ntosis/ARMGarageDoor/PCB/design/Untitled 1.ods

pin name | pin no | connection | info
cph | 22 | 47nF capacitor | default
cpl | 23 | 47nF capacitor | default
dvdd | 1 | 1 uF capacitor | default
EN/IN1 | 7 | PB9 PWM
DISABLE | 9 | PB15 OUT
IPROPI1 | 10 | PA1 ADC | R(SENSE)= k × 3 V / I, k=1100, I max current = 7.8 A R=412ohm, 21mW
IPROPI2 | 12 | PA2 ADC | R(SENSE)= k × 3 V / I, k=1100, I max current = 7.8 A R=412ohm, 21mW
nITRIP | 5 | nc | enables current protection at 6.5 A and off time is 40uS
nOL | 6 | connect to dvdd | disables openload detection
MODE | 3 | connect to dvdd | pwm mode
PH/IN2 | 8 | PB8 PWM
sr | 4 |  | slew rate 18,3 v/us. 68 k Ω ± 5% to GND
src | 16 | to gnd
src | 17 | to gnd
VCP | 21 |  | Chargepumpoutput.Connecta 16-V,1-μF ceramiccapacitorfromthis pin tothe VM supply.
VM | 13 |  | Powersupply This pin is the motor supply voltage.
VM | 20 |  | Powersupply This pin is the motor supply voltage.
nFAULT | 2 | PB1 IN | Faultindicationpin. This pin is pulled logic low with a fault condition.This open-drain output requiresan external pullup resistor. 10Kohm
nSLEEP | 11 | PB11 OUT | Sleep input.To enter a low-power sleepmode,set this pin logic low.
