ntosis/ARMGarageDoor/PCB/motordriver.brd

## EAGLE design PCB/motordriver.brd (2019-07-03)

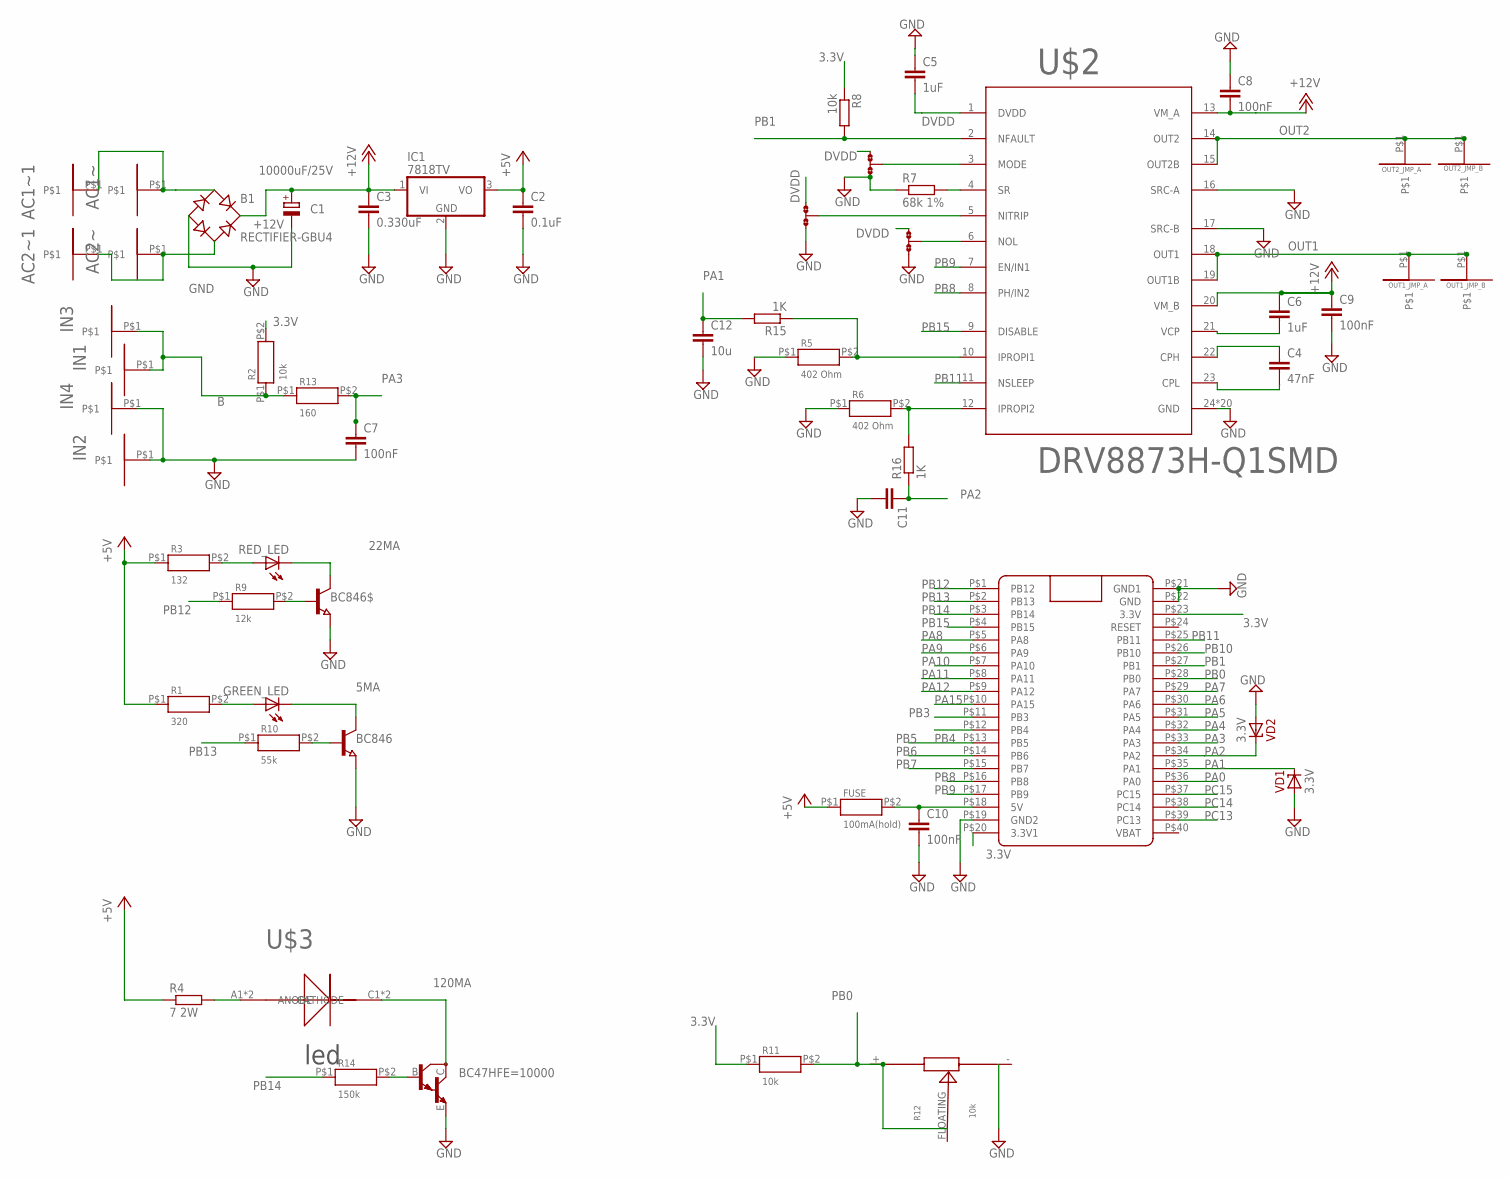
[picture p3: schematic motordriver.sch]

Parts:
AC1~, AC1~1, AC2~, AC2~1: SMDPAD; 1.5X7MMPAD
B1: RECTIFIER-GBU4; GBU4
BC47HFE=10000: MMBTA14LT1; SOT23-BEC
BC846, BC846$: NPN-TRANSISTOR_SOT23; SOT23
C1: 10000uF/25V; E7,5-18
C2: 0.1uF; C1206
C3: 0.330uF; C1206
C4: 47nF; C1206K
C5, C6: 1uF; C1206K
C7: 100nF; C1206
C8, C9: 100nF; C0805
C10: 100nF; C0805K
C11: C-EUC0805K; C0805K
C12: 10u; C0805K
FUSE: 100mA(hold); 0805
GREEN_LED: LEDCHIPLED_0805; CHIPLED_0805
IC1: 7818TV; TO220V
IN1, IN2, IN3, IN4: SMDPAD; 1.5X7MMPAD
JMP1, JMP2, JMP3: 0R-JUMPA; A0R-JMP
OUT1_JMP_A, OUT1_JMP_B, OUT2_JMP_A, OUT2_JMP_B: SMDPAD; 1.5X7MMPAD
R1: 320; 0805
R2, R11: 10k; 0805
R3: 132; 0805
R4: 7 2W; R1210
R5, R6: 402 Ohm; 0805
R7: 68k 1%; R0805
R8: 10k; R0805
R9: 12k; 0805
R10: 55k; 0805
R12: 10k; 3X1MM
R13: 160; 0805
R14: 150k; 0805
R15, R16: 1K; R0805
RED_LED: LEDCHIPLED_0805; CHIPLED_0805
U$1: BLUE_PILL
U$2: DRV8873H-Q1SMD; HTSSOP24
U$3: POWER_LED; OSRAMLED
VD1, VD2: 3.3V; DO35-7

Connections:
3.3V: R2.P$2, R8.1, R11.P$1, U$1.P$20 (3.3V1), U$1.P$23 (3.3V)
5MA: BC846.3 (C), GREEN_LED.C
22MA: BC846$.3 (C), RED_LED.C
120MA: BC47HFE=10000.C, U$3.C1 (CATHODE), U$3.C2 (CATHODE)
+5V: C2.1, FUSE.P$1, IC1.3 (VO), R1.P$1, R3.P$1, R4.1
+12V: B1.+, C1.+, C3.1, C6.1, C8.2, C9.1, IC1.1 (VI), U$2.13 (VM_A), U$2.20 (VM_B)
B: IN1.P$1, IN3.P$1, R2.P$1, R13.P$1
DVDD: C5.2, JMP1.1, JMP2.1, JMP3.1, U$2.1 (DVDD)
GND: B1.-, BC47HFE=10000.E, BC846.2 (E), BC846$.2 (E), C1.-, C2.2, C3.2, C5.1, C7.2, C8.1, C9.2, C10.2, C11.2, C12.2, IC1.2 (GND), IN2.P$1, IN4.P$1, JMP1.3, JMP2.3, JMP3.3, R5.P$1, R6.P$1, R7.1, R12.-, U$1.P$19 (GND2), U$1.P$21 (GND1), U$1.P$22 (GND), U$2.16 (SRC-A), U$2.17 (SRC-B), U$2.24 (GND), U$2.GND_ (GND), U$2.P$1 (GND), U$2.P$2 (GND), U$2.P$3 (GND), U$2.P$4 (GND), U$2.P$5 (GND), U$2.P$6 (GND), U$2.P$7 (GND), U$2.P$8 (GND), U$2.P$9 (GND), U$2.P$10 (GND), U$2.P$11 (GND), U$2.P$12 (GND), U$2.P$13 (GND), U$2.P$14 (GND), U$2.P$15 (GND), U$2.P$16 (GND), U$2.P$18 (GND), U$2.P$19 (GND), VD1.A, VD2.A
unnamed: AC1~.P$1, AC1~1.P$1, B1.AC1
unnamed: AC2~.P$1, AC2~1.P$1, B1.AC2
unnamed: C4.1, U$2.22 (CPH)
unnamed: C4.2, U$2.23 (CPL)
unnamed: JMP2.2, U$2.6 (NOL)
unnamed: JMP1.2, U$2.5 (NITRIP)
unnamed: JMP3.2, U$2.3 (MODE)
unnamed: R7.2, U$2.4 (SR)
unnamed: C6.2, U$2.21 (VCP)
unnamed: R3.P$2, RED_LED.A
unnamed: GREEN_LED.A, R1.P$2
unnamed: BC846$.1 (B), R9.P$2
unnamed: BC846.1 (B), R10.P$2
unnamed: R4.2, U$3.A1 (ANODE), U$3.A2 (ANODE)
unnamed: BC47HFE=10000.B, R14.P$2
unnamed: C10.1, FUSE.P$2, U$1.P$18 (5V)
unnamed: R5.P$2, R15.1, U$2.10 (IPROPI1)
unnamed: R6.P$2, R16.2, U$2.12 (IPROPI2)
OUT1: OUT1_JMP_A.P$1, OUT1_JMP_B.P$1, U$2.18 (OUT1), U$2.19 (OUT1B)
OUT2: OUT2_JMP_A.P$1, OUT2_JMP_B.P$1, U$2.14 (OUT2), U$2.15 (OUT2B)
PA0: U$1.P$36 (PA0)
PA1: C12.1, R15.2, U$1.P$35 (PA1), VD1.C
PA2: C11.1, R16.1, U$1.P$34 (PA2), VD2.C
PA3: C7.1, R13.P$2, U$1.P$33 (PA3)
PA4: U$1.P$32 (PA4)
PA5: U$1.P$31 (PA5)
PA6: U$1.P$30 (PA6)
PA7: U$1.P$29 (PA7)
PA8: U$1.P$5 (PA8)
PA9: U$1.P$6 (PA9)
PA10: U$1.P$7 (PA10)
PA11: U$1.P$8 (PA11)
PA12: U$1.P$9 (PA12)
PA15: U$1.P$10 (PA15)
PB0: R11.P$2, R12.+, R12.FLOATING, U$1.P$28 (PB0)
PB1: R8.2, U$1.P$27 (PB1), U$2.2 (NFAULT)
PB3: U$1.P$11 (PB3)
PB4: U$1.P$12 (PB4)
PB5: U$1.P$13 (PB5)
PB6: U$1.P$14 (PB6)
PB7: U$1.P$15 (PB7)
PB8: U$1.P$16 (PB8), U$2.8 (PH/IN2)
PB9: U$1.P$17 (PB9), U$2.7 (EN/IN1)
PB10: U$1.P$26 (PB10)
PB11: U$1.P$25 (PB11), U$2.11 (NSLEEP)
PB12: R9.P$1, U$1.P$1 (PB12)
PB13: R10.P$1, U$1.P$2 (PB13)
PB14: R14.P$1, U$1.P$3 (PB14)
PB15: U$1.P$4 (PB15), U$2.9 (DISABLE)
PC13: U$1.P$39 (PC13)
PC14: U$1.P$38 (PC14)
PC15: U$1.P$37 (PC15)

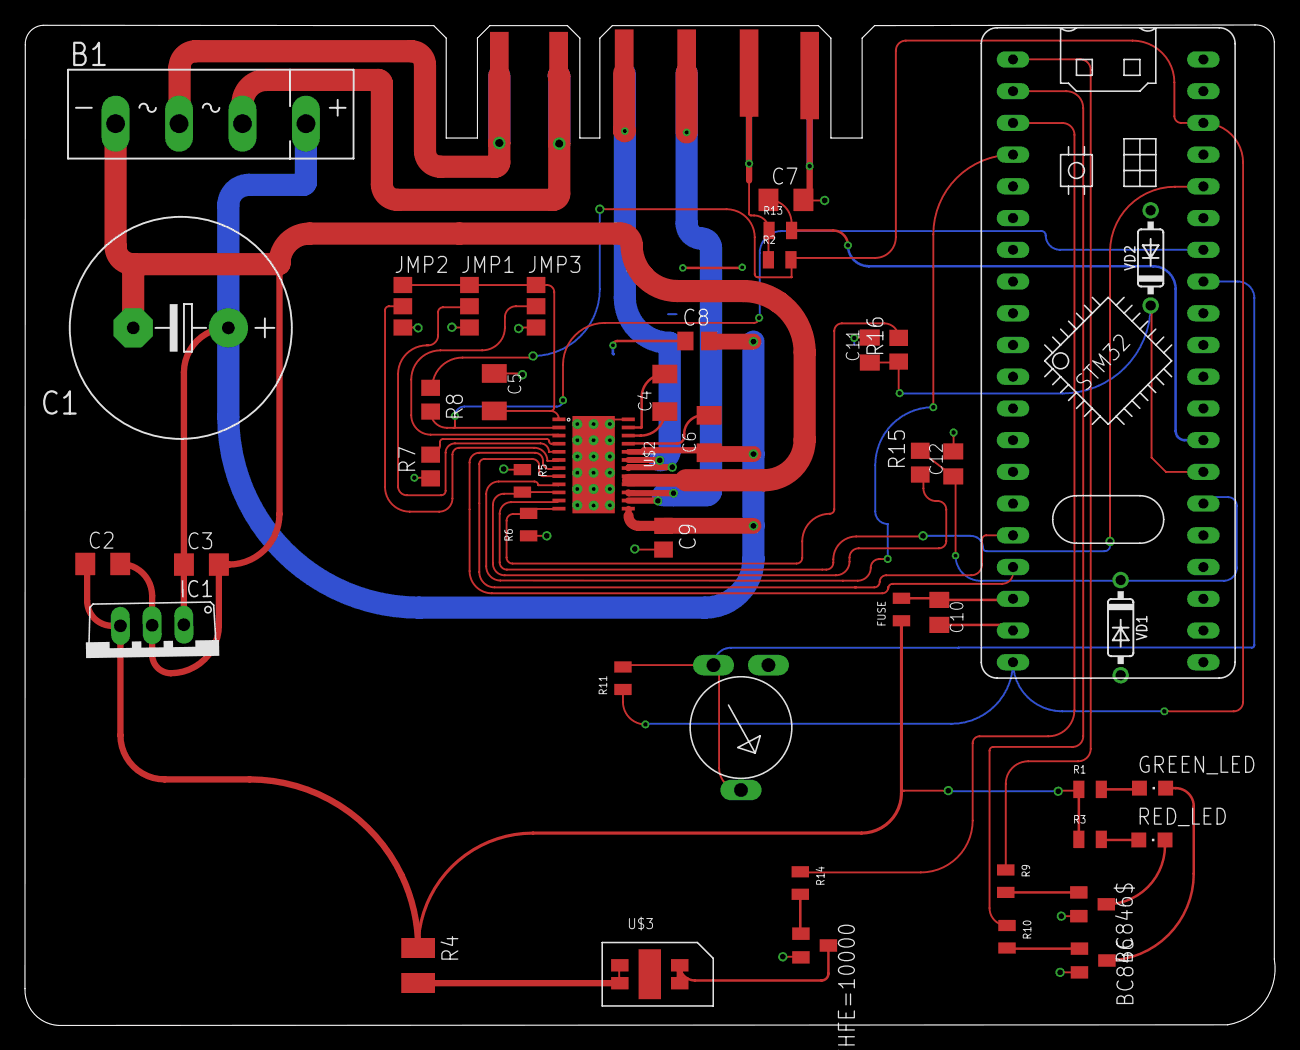
[picture p4: board motordriver.brd from above]

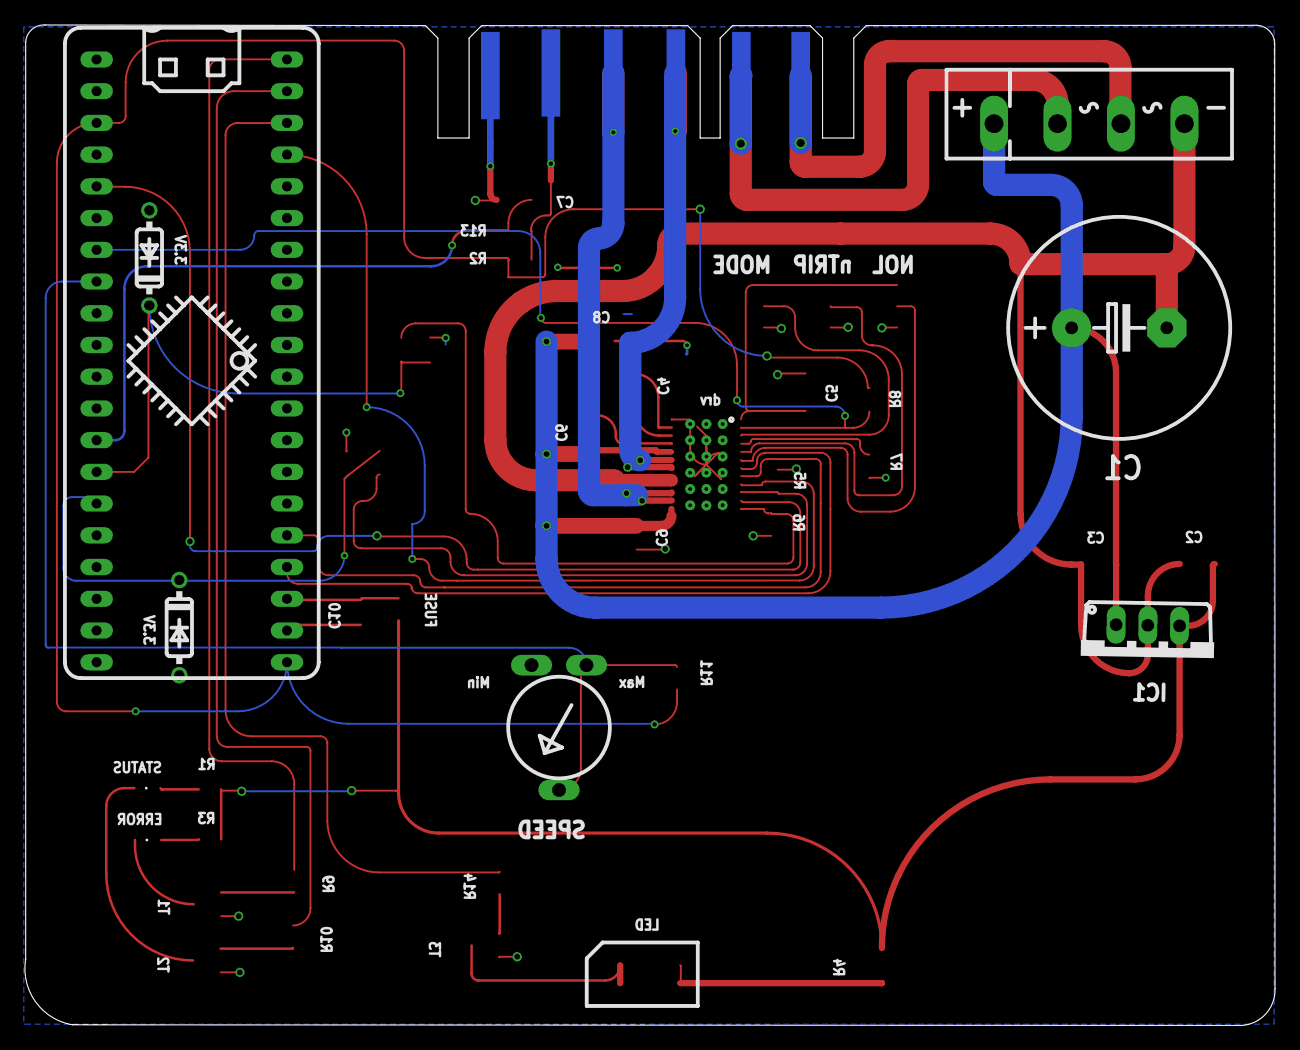
[picture p5: board motordriver.brd from below]

Board: 2 copper layers, 100.1 x 80.1 mm, 56 parts (6 on the bottom side), 41 nets.
