ntosis/ARMGarageDoor/SW/SWProject/src/main.c

/**
  ******************************************************************************
  * @file           : main.c
  * @brief          : Main program body
  ******************************************************************************
  * This notice applies to any and all portions of this file
  * that are not between comment pairs USER CODE BEGIN and
  * USER CODE END. Other portions of this file, whether 
  * inserted by the user or by software development tools
  * are owned by their respective copyright owners.
  *
  * Copyright (c) 2019 STMicroelectronics International N.V. 
  * All rights reserved.
  *
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
  ******************************************************************************
  */
/* Includes ------------------------------------------------------------------*/

/* USER CODE BEGIN Includes */
#include "main.h"
#include "stm32f1xx_hal.h"
#include "cmsis_os.h"
#include "hardwareCfg.h"
#include "basicLEDDriverSWC.h"
#include "basicADCSWC.h"
#include "basicErrorHandlerSWC.h"
#include "basicPWMMotorDriver.h"
#include "MainApplicationSystem.h"
/* USER CODE END Includes */



/* USER CODE BEGIN PV */
osThreadId defaultTaskHandle;
osThreadId Task50mskHandle;
/* USER CODE END PV */

void Task50ms(void const * argument);
void Task100ms(void const * argument);
/* USER CODE BEGIN PFP */

/* USER CODE END PFP */

/**
  * @brief  The application entry point.
  *
  * @retval None
  */
int main(void)
{
  /* MCU Configuration----------------------------------------------------------*/

  /* Reset of all peripherals, Initializes the Flash interface and the Systick. */
  HAL_Init();

  /* Configure the system clock */
  SystemClock_Config();

  /* Initialize all configured peripherals */
  MX_GPIO_Init();
  MX_TIM4_Init();
  MX_ADC1_Init();

  /* USER CODE BEGIN 2 */
  basicStartTIM4();
  MainApplicationSystem_initialize();
  /* USER CODE END 2 */

  /* USER CODE BEGIN RTOS_MUTEX */
  /* add mutexes, ... */
  /* USER CODE END RTOS_MUTEX */

  /* USER CODE BEGIN RTOS_SEMAPHORES */
  /* add semaphores, ... */
  /* USER CODE END RTOS_SEMAPHORES */

  /* USER CODE BEGIN RTOS_TIMERS */
  /* start timers, add new ones, ... */
  /* USER CODE END RTOS_TIMERS */

  /* Create the thread(s) */
  /* definition and creation of defaultTask */
  osThreadDef(Task50ms_, Task50ms, osPriorityRealtime, 0, 512);
  Task50mskHandle = osThreadCreate(osThread(Task50ms_), NULL);

  /* USER CODE BEGIN RTOS_THREADS */
  osThreadDef(defaultTask, Task100ms, osPriorityRealtime, 0, 512);
  defaultTaskHandle = osThreadCreate(osThread(defaultTask), NULL);
  /* USER CODE END RTOS_THREADS */

  /* USER CODE BEGIN RTOS_QUEUES */
  /* add queues, ... */
/*  __HAL_RCC_DBGMCU_CLK_ENABLE();
  __HAL_DBGMCU_FREEZE_IWDG();*/
  MX_IWDG_Init();
  __HAL_IWDG_START(&hiwdg);
  /* USER CODE END RTOS_QUEUES */
 

  /* Start scheduler */
  osKernelStart();
  
  /* We should never get here as control is now taken by the scheduler */

  /* Infinite loop */
  /* USER CODE BEGIN WHILE */
  while (1)
  {

  /* USER CODE END WHILE */

  /* USER CODE BEGIN 3 */

  }
  /* USER CODE END 3 */

}

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
/* USER CODE BEGIN 4 */
void Task50ms(void const * argument)
{
	/* Prevent unused argument(s) compilation warning */
	UNUSED(argument);

	portTickType xLastWakeTime;
	    const portTickType xDelay = 50 / portTICK_RATE_MS;
	    // Initialise the xLastWakeTime variable with the current time.
	         xLastWakeTime = xTaskGetTickCount ();
			while(1) {
				/*  Update the time interface for the application module*/
				HAL_getMstime_sig = HAL_GetTick();

				basicReadInputs();

				basicGlobalLedDriver(HAL_GetTick());


				// Wait for the next cycle.
				vTaskDelayUntil( &xLastWakeTime, xDelay );
			}

}
/* USER CODE END 4 */

/* StartDefaultTask function */
void Task100ms(void const * argument)
{
	/* Prevent unused argument(s) compilation warning */
	UNUSED(argument);
  /* USER CODE BEGIN 5 */
	portTickType xLastWakeTime;
	    const portTickType xDelay = 100 / portTICK_RATE_MS;
	    // Initialise the xLastWakeTime variable with the current time.
	         xLastWakeTime = xTaskGetTickCount ();
			while(1) {

				static unsigned char internalTaskCounter = 0;

				basicReadADCRawValues();

				basicADCErrorHandler();

				basicCheckGlobalErrors();

				MainApplicationSystem_step();

				basicMotorTask();

				if(internalTaskCounter>0) {
					/* refresh IWDG*/
					HAL_IWDG_Refresh(&hiwdg);

					internalTaskCounter = 0;
				}

				internalTaskCounter++;
				// Wait for the next cycle.
				vTaskDelayUntil( &xLastWakeTime, xDelay );
			}
  /* USER CODE END 5 */ 
}
/**
  * @brief  This function is executed in case of error occurrence.
  * @param  file: The file name as string.
  * @param  line: The line in file as a number.
  * @retval None
  */
void _Error_Handler(char *file, int line)
{
  /* Prevent unused argument(s) compilation warning */
	UNUSED(line); UNUSED(file);
  /* USER CODE BEGIN Error_Handler_Debug */
  /* User can add his own implementation to report the HAL error return state */
  while(1)
  {
  }
  /* USER CODE END Error_Handler_Debug */
}

#ifdef  USE_FULL_ASSERT
/**
  * @brief  Reports the name of the source file and the source line number
  *         where the assert_param error has occurred.
  * @param  file: pointer to the source file name
  * @param  line: assert_param error line source number
  * @retval None
  */
void assert_failed(uint8_t* file, uint32_t line)
{ 
  /* USER CODE BEGIN 6 */
  /* User can add his own implementation to report the file name and line number,
     tex: printf("Wrong parameters value: file %s on line %d\r\n", file, line) */
  /* USER CODE END 6 */
}
#endif /* USE_FULL_ASSERT */

/**
  * @}
  */

/**
  * @}
  */

/************************ (C) COPYRIGHT STMicroelectronics *****END OF FILE****/
