ntosis/ARMGarageDoor/SW/SWProject/cubeConfig/stmf1/stmf1.ioc

Mcu.UserName=STM32F103C8Tx
PA1.Signal=ADCx_IN1
PA13.Signal=SYS_JTMS-SWDIO
PA14.Signal=SYS_JTCK-SWCLK
PA2.Signal=ADCx_IN2
PA3.Signal=GPIO_Input
PB0.Signal=ADCx_IN8
PB1.Signal=GPIO_Input
PB11.Signal=GPIO_Output
PB12.Signal=GPIO_Output
PB13.Signal=GPIO_Output
PB14.Signal=GPIO_Output
PB15.Signal=GPIO_Output
PB8.Signal=S_TIM4_CH3
PB9.Signal=S_TIM4_CH4
PC14-OSC32_IN.Signal=RCC_OSC32_IN
PC15-OSC32_OUT.Signal=RCC_OSC32_OUT
PD0-OSC_IN.Signal=RCC_OSC_IN
PD1-OSC_OUT.Signal=RCC_OSC_OUT
