ntosis/ARMGarageDoor/(commit log)

2019-05-11 Simulation is working. Motor derection and on/off seems ok.
2019-05-11 set Zero current error during the motor is active.
2019-05-17 Added the PCB init files.
    [motordriver.brd, motordriver.sch]
2019-05-20 work in PCB
    [motordriver.brd, motordriver.sch]
2019-05-22 work in board
    [motordriver.brd, motordriver.sch]
2019-05-22 more work in board
    [motordriver.brd]
2019-06-07 some changes in resistor values.
    [motordriver.brd, motordriver.sch]
2019-06-12 fixed the error handlig to stop the motor permanent.
2019-06-12 software is working. Send the sum of Iprop1 and Iprop2 to application software.
    [motordriver.brd, motordriver.sch]
2019-07-03 added Low pass rc filter for the IOPROPx output
    [motordriver.brd, motordriver.sch]
